mrdevlin6/embryoRobots/README.md

# Material-like robotic collectives with spatiotemporal control of strength and shape
Documentation for a embryo-inspired robotic collective

Simulation code is here: https://github.com/ksw851216/Robotic_collectives_simulation
