mrdevlin6/embryoRobots/PCB Files/FAB-Embryo_Photo-diode_2-17-A.12/bom.xls

Comment | Designator | Footprint | JLCPCB Part #
AP9971GM | Q2 | FDS5672 | C879018
LM324DR2G | U1,U2 | LM324 | C63820
CR0402F470KQ10Z | R1,R2,R3,R4,R5,R6,R7,R8 | 4020 | C881318
BPW34S-Z | D1,D2,D3,D4,D5,D6,D7,D8 | PCB-u3l9kgsljwenhcsxbo5j-1 | C67891
