mrdevlin6/embryoRobots/PCB Files/PCBA-Embryo_Photo-diode_2-17-[NO VARIATIONS]-A.12/BOM/BOM_PartType-Embryo_Photo-diode_2-17.xlsx

Comment | Description | Designator | Footprint | LibRef | Quantity
=Value | Nano 3.0 Atmel Atmega 328 MCU board placed on 8.4mm high female headers | A1 | PCB-djo2kohhk2l0t1bx5udn-1 | CMP-f1bd39841b322e7a-83 | 1
throughole Lipo | two holes for battery attachment | BT1, BT2 | PCB-rfcdqsqczebt5l0rgh1x-1 | CMP-qvx086i6wemywnzvz4b2-1 | 2
Osram Opto BPW 34 S-Z | Photodiode PIN Chip 850nm 0.62A/W Sensitivity 2-Pin DIL SMT | D1, D2, D3, D4, D5, D6, D7, D8 | PCB-u3l9kgsljwenhcsxbo5j-1 | CMP-44758e30df1e9bb2-1 | 8
ERM Motor Mount | Througholes for 25mm ERM motor | ERM1 | PCB-l2lf4iprv05hfms8uvfl-1 | CMP-nyhyf6joh24rsbttegdy-1 | 1
Motor mounting pads | https://www.aliexpress.com/i/32655353303.html, 3V | M1, M2, M3, M4, M5, M6, M7, M8 | New footprint 1 | CMP-zu337m1ficybk1lwslfg-3 | 8
SparkFun ROB-13845 | TB6612FNG Motor Driver Board | MC1 | TB6612FNG | CMP-86804b0e56905947-9 | 1
Switch | Switch Slide ON None ON SPDT Top Slide 6A 250VAC 28VDC PC Pins Thru-Hole Bulk | ON1, SENSE ON1 | C&K Components 1101M2S3CQE2-Footprint-1 | CMP-858a4ca6a0c15a4d-1 | 2
TE Connectivity / AMP 3-641215-3 | Connector Wire to Board Header 3 Position 2.54mm Solder Straight Thru-Hole | Probe | PCB-6wtyvow7wwcldc106e53-1 | CMP-ba65713570b965a2-4 | 1
ON Semiconductor FDS5670 | N-Channel 60 V 14 mOhm SMT PowerTrench Mosfet SOIC-8 | Q2 | PCB-ivtzqriy3c14275itzi3-1 | CMP-f7513b5d6af52896-2 | 1
TE Connectivity CRGCQ0402F470K | Res Thick Film 0402 470K Ohm 1% 0.063W(1/16W) ±100ppm/C Pad SMD Automotive T/R | R1, R2, R3, R4, R5, R6, R7, R8 | PCB-8tuutlkq7p1aj3t2dfdp-1 | CMP-e2a22ec415373d65-2 | 8
LM324DR2G | Single Supply Quad Operational Amplifier, 3 to 32 V, 0 to 70 degC, 14-Pin SOIC, Pb-Free, Tape and Reel | U1, U2 | LM324 | CMP-1320582-4 | 2
