mrdevlin6/embryoRobots/PCB Files/PCBA-Embryo_Photo-diode_2-17-[NO VARIATIONS]-A.12/Assembly.PDF

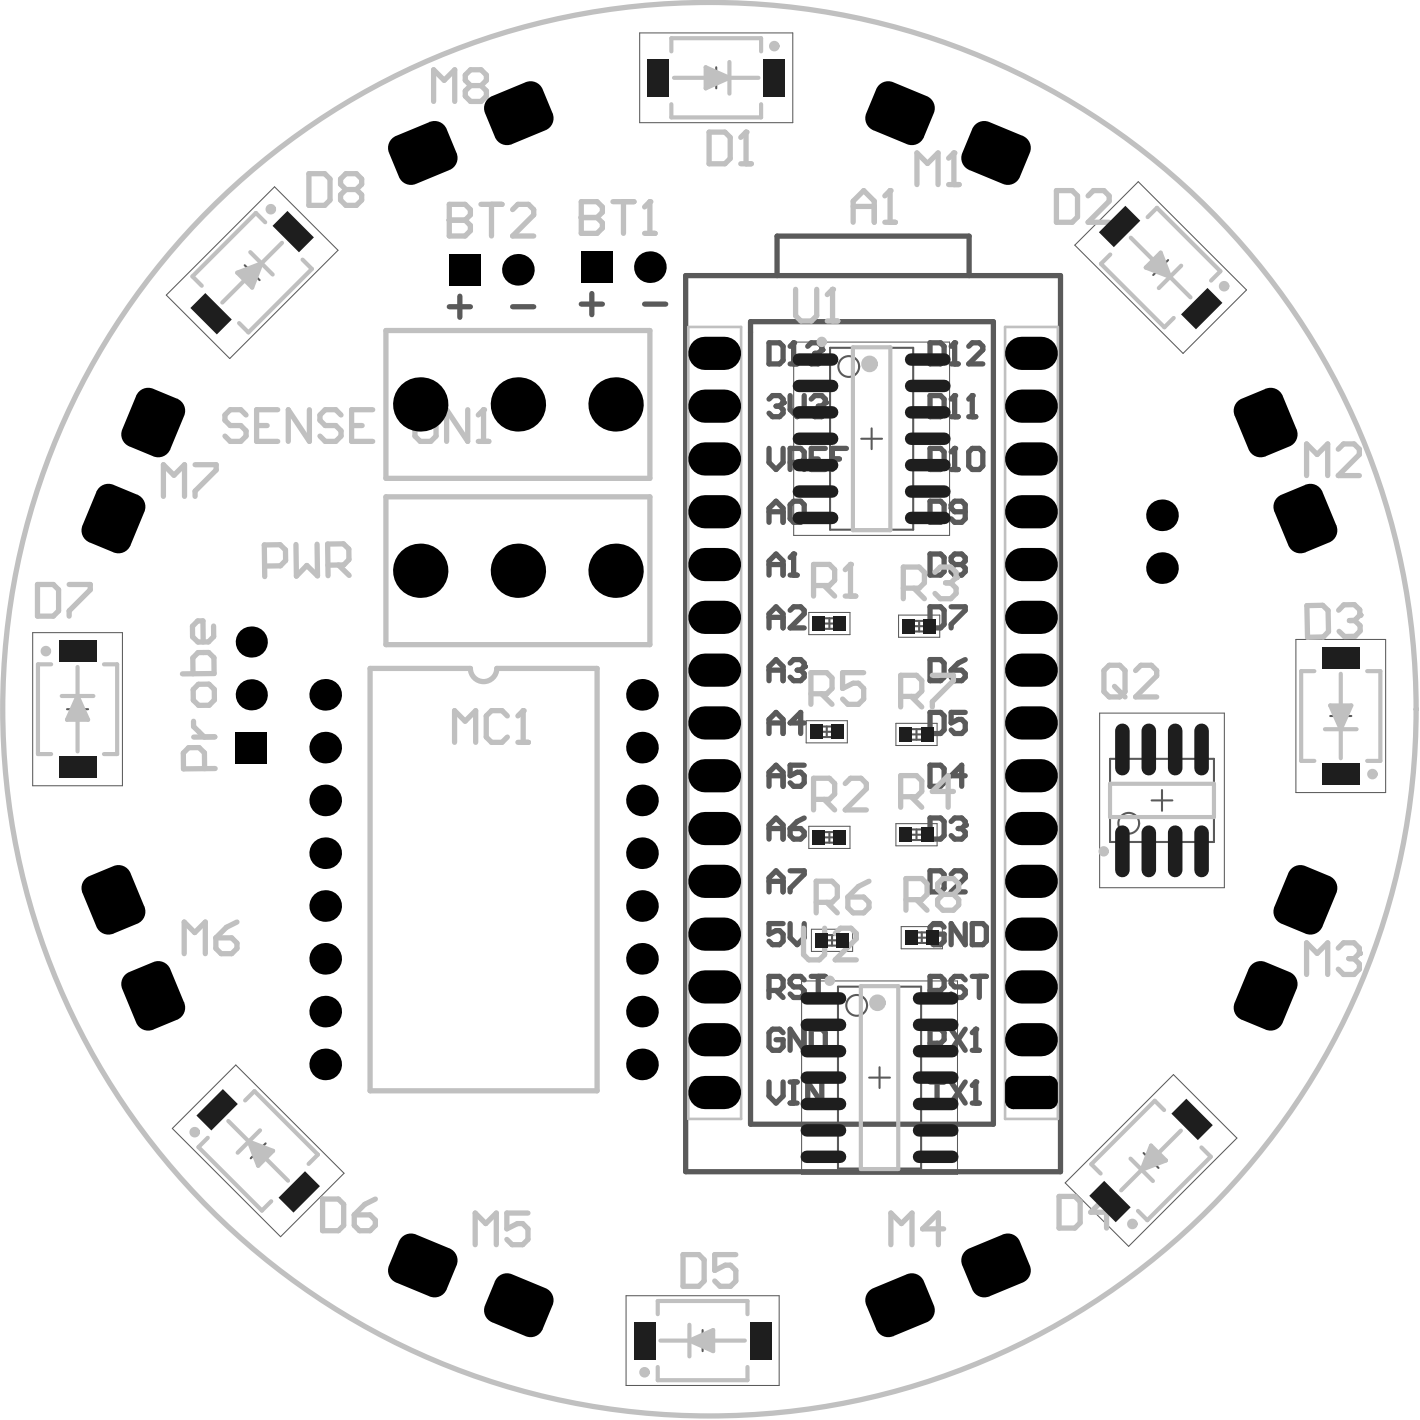
[picture p1: page 1]

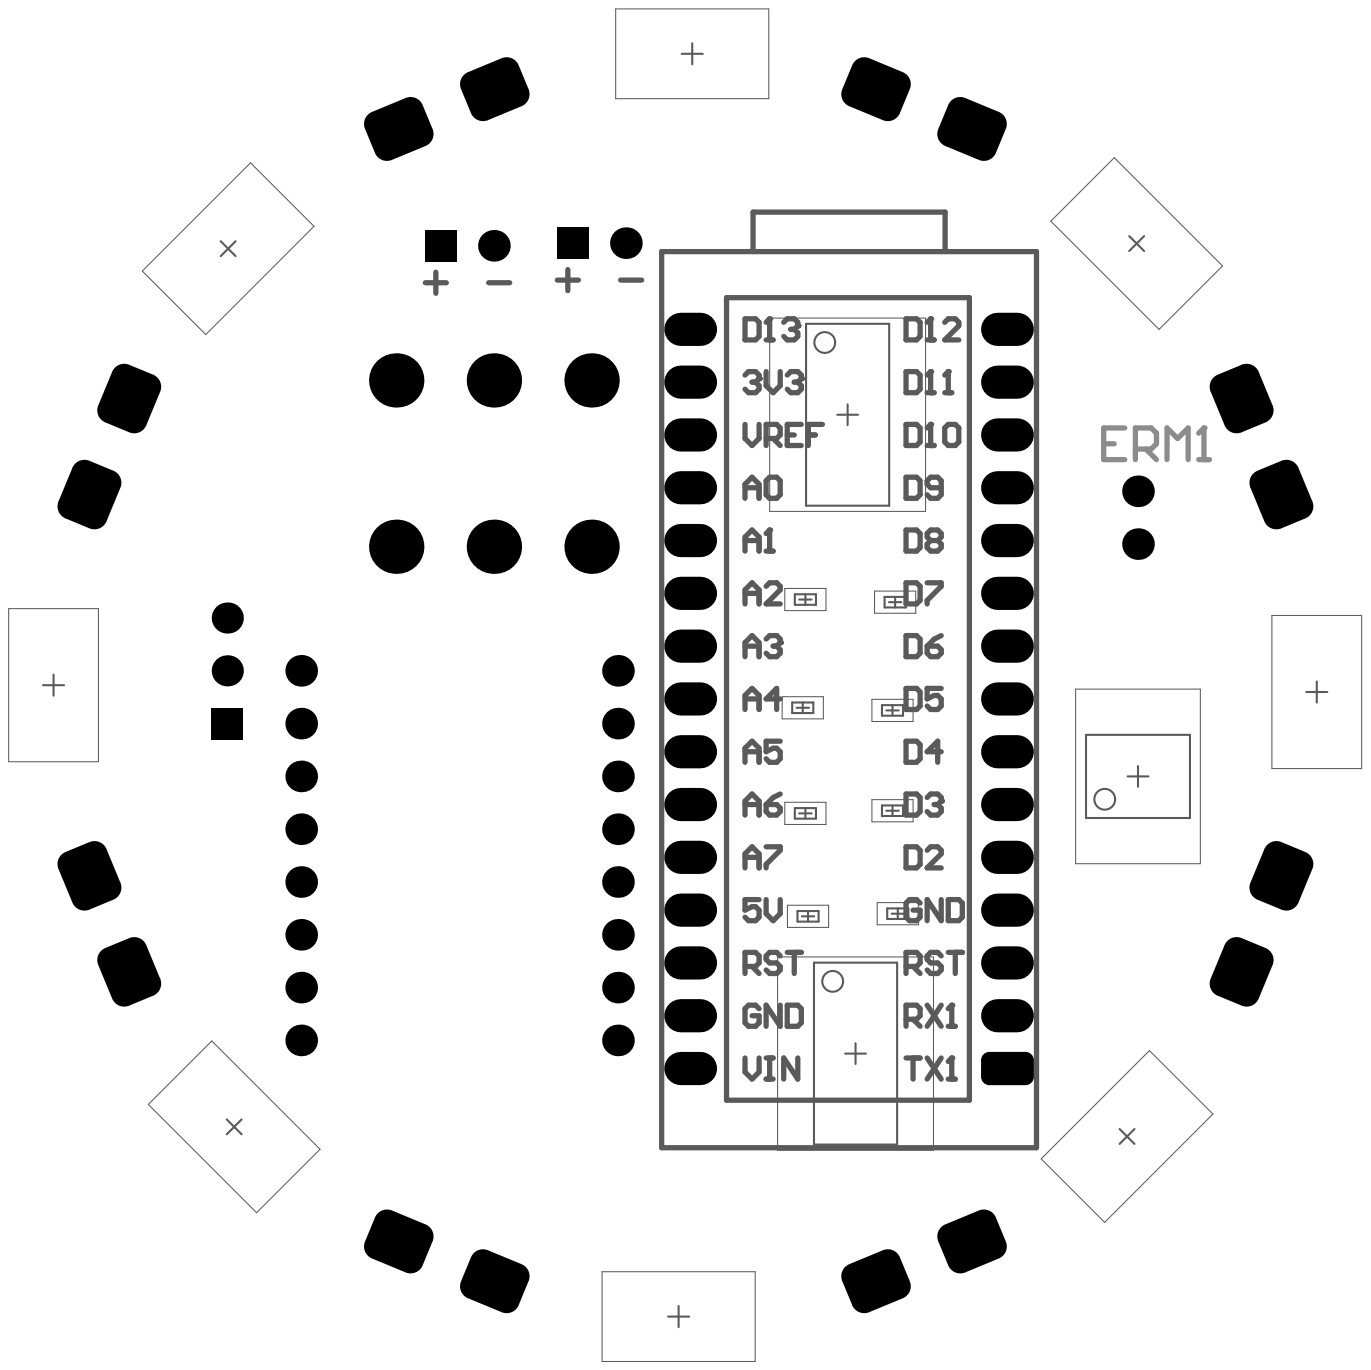
[picture p2: page 2]
