mrdevlin6/embryoRobots/(commit log)

2023-06-01 Signal optimization to finalize the fluidization signal
    Quick survey of three different signal amplitude distributions to finalize the fluidization signal. All fixed at 110PWM drive ~3.6V.
    [drive110fluct60SignalCheck_Uniform.csv, drive111fluct60SignalCheck_Gaussian.csv, drive112fluct60SignalCheck_Bimodal.csv]
2024-05-06 Add files via upload
    Data and scripts used for plotting figures
    [drive140fluct0compressionpower6kg.csv, drive60fluct40compressionpower6kg.csv]
2024-05-06 Update and rename fixedOrientationGaussianSignal_BimodalFinal.ino to fixedOrientationSignal_BimodalFinal.ino
    [fixedOrientationSignal_BimodalFinal.ino]
2024-12-15 Update and rename drive140fluct0compressionpower6kg.csv to Data Processing Scripts/drive140fluct0compressionpower6kg.csv
    [drive140fluct0compressionpower6kg.csv]
2024-12-15 Update and rename drive60fluct40compressionpower6kg.csv to Data Processing Scripts/drive60fluct40compressionpower6kg.csv
    [drive60fluct40compressionpower6kg.csv]
2024-12-15 Update and rename fixedOrientationSignal_BimodalFinal.ino to Robot Code/fixedOrientationSignal_BimodalFinal.ino
    [fixedOrientationSignal_BimodalFinal.ino]
2024-12-15 Rename powerData.mat to Data Processing Scripts/powerData.mat
2024-12-15 Update and rename power_guaranteed_success.m to Data Processing Scripts/power_guaranteed_success.m
2024-12-15 Rename PCB_Embryo.zip to PCB Files/PCB_Embryo.zip
